RobertSwirsky/weikeypad/Weigand.3mf

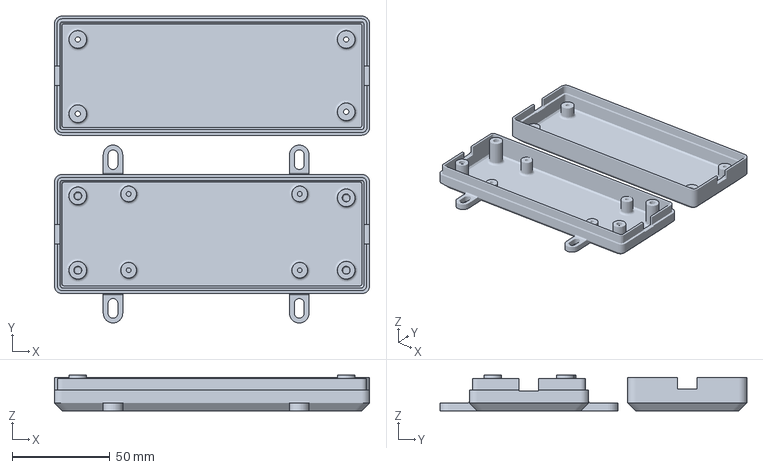
[picture p1: CAD file, 2026-02-12]
Weigand.3mf
161.2 x 157.0 x 18.2 mm
