RobertSwirsky/weikeypad/(list of files, cad)

Other CAD files:
Weigand.stl
