RobertSwirsky/weikeypad/schematic.pdf

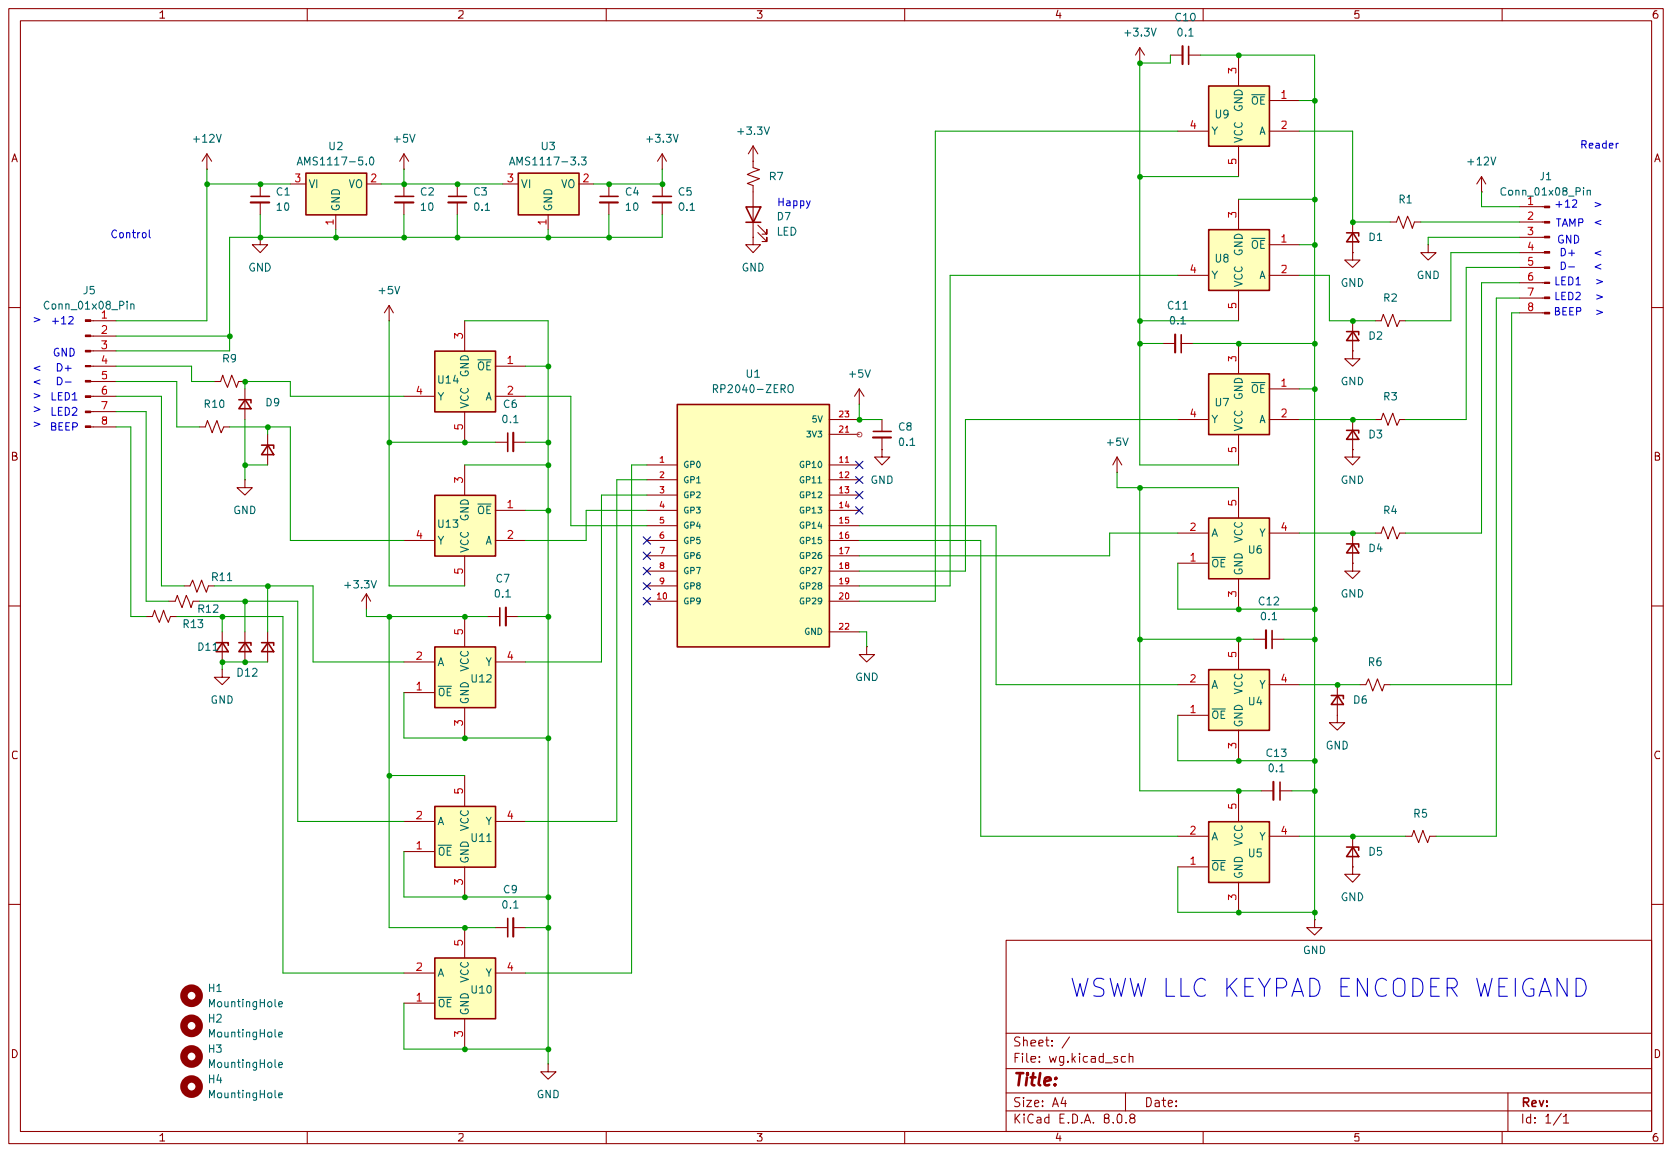
[picture p2: page 1]
