RobertSwirsky/weikeypad/KiCad/wg.kicad_pcb

## KiCad design KiCad/wg.kicad_pcb (2025-10-17)

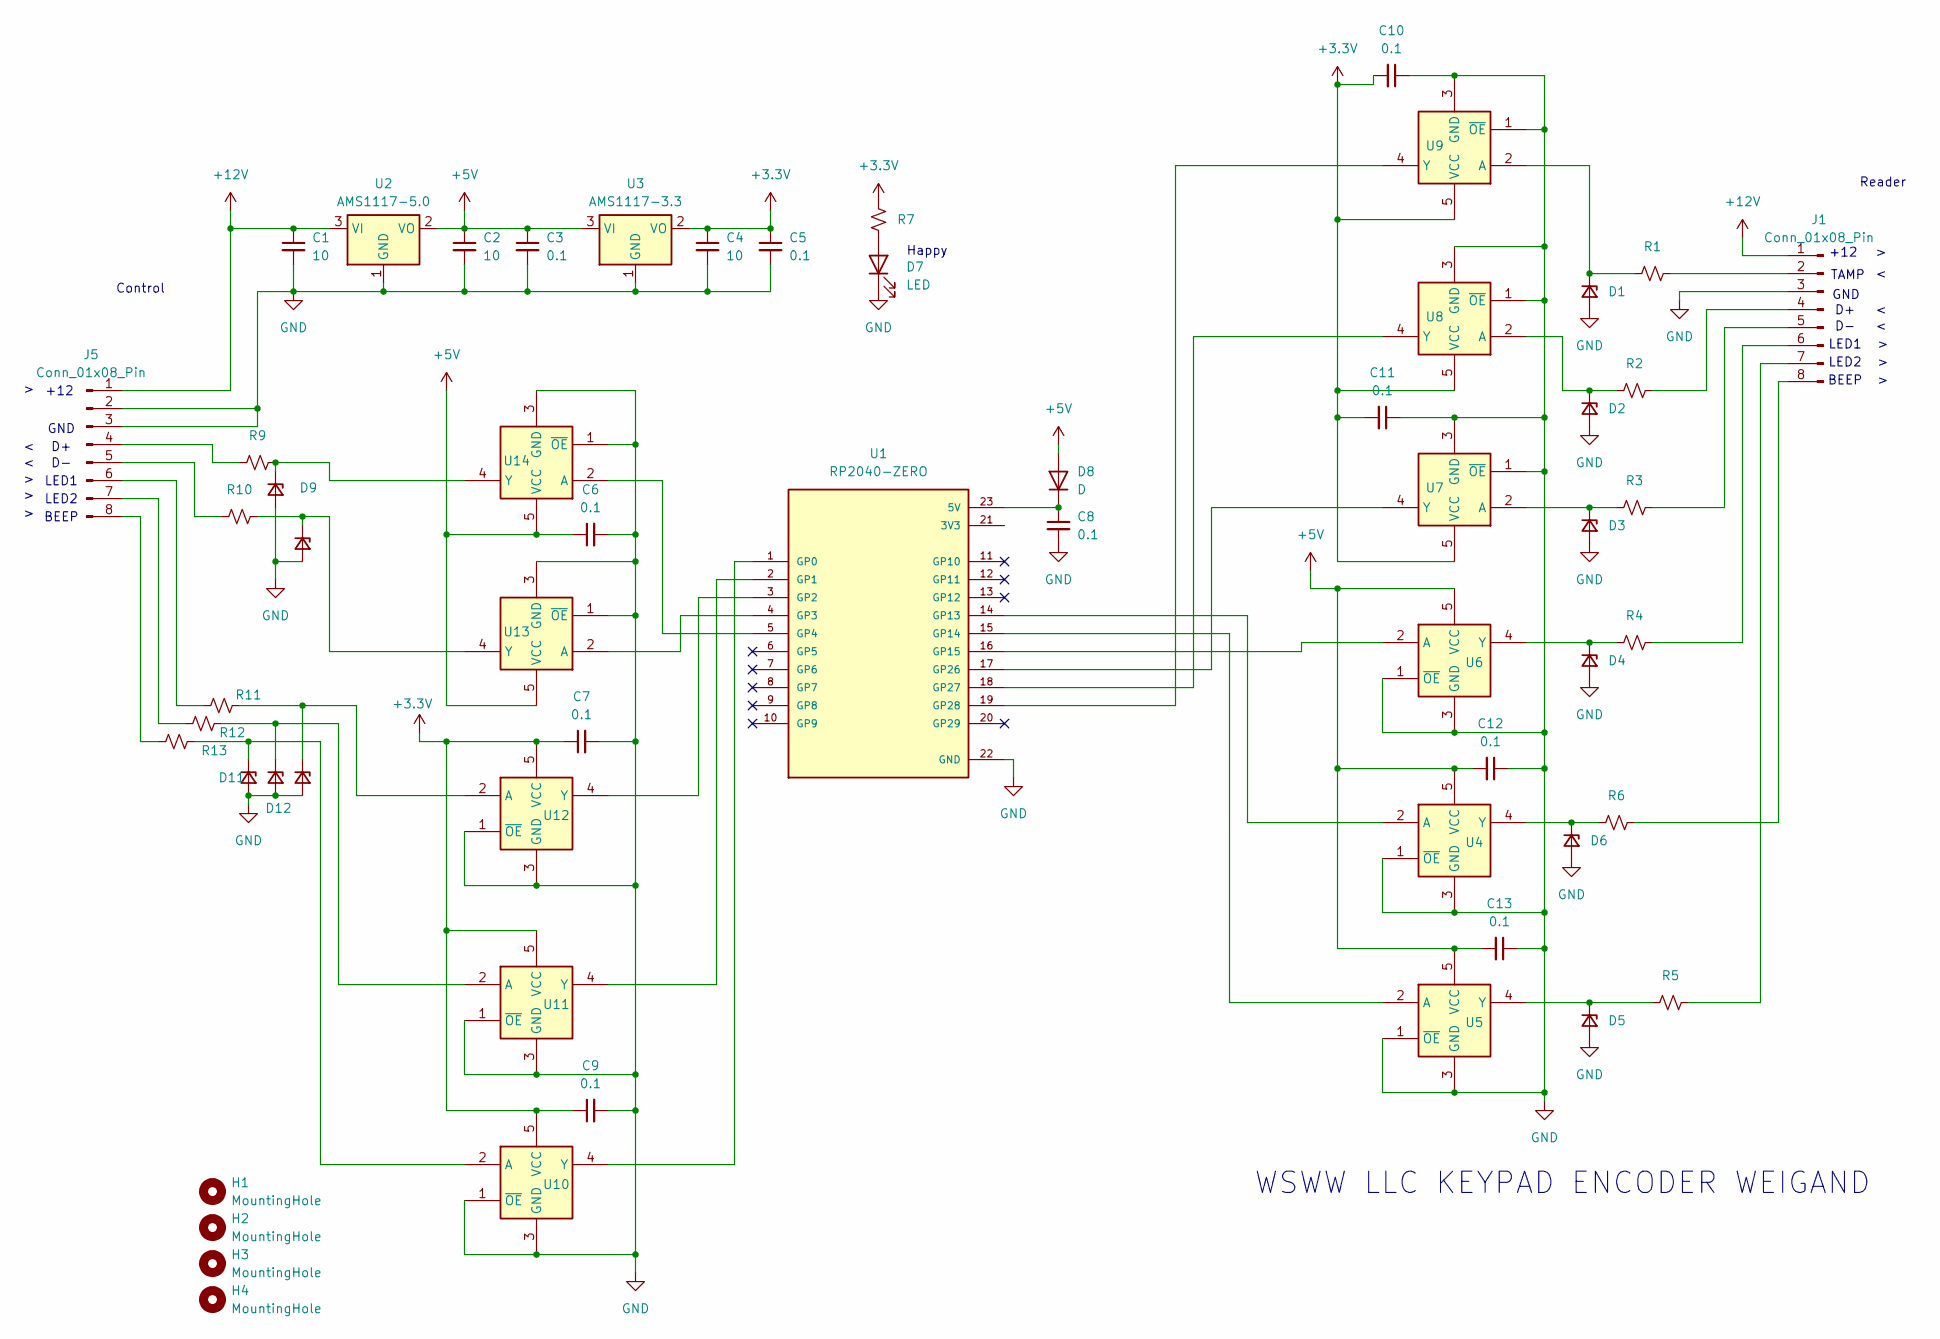
[picture p3: schematic wg.kicad_sch]

Parts:
C1, C2, C4: 10; CP_Radial_D4.0mm_P2.00mm
C3, C5, C6, C7, C8, C9, C10, C11, C12, C13: 0.1; C_Disc_D3.0mm_W1.6mm_P2.50mm
D1, D2, D3, D4, D5, D6, D9, D10, D11, D12, D13: D_Zener_Small; D_SOD-323_HandSoldering
D7: LED; R_1206_3216Metric_Pad1.30x1.75mm_HandSolder
D8: D
H1, H2, H3, H4: MountingHole; MountingHole_3mm
J1, J5: Conn_01x08_Pin; PhoenixContact_MC_1,5_8-G-3.5_1x08_P3.50mm_Horizontal
R1, R2, R3, R4, R5, R6, R7, R9, R10, R11, R12, R13: R_Small_US; R_1206_3216Metric_Pad1.30x1.75mm_HandSolder
U1: RP2040-ZERO; MODULE_RP2040-ZERO; PARTREV NA
U2: AMS1117-5.0; SOT-223-3_TabPin2
U3: AMS1117-3.3; SOT-223-3_TabPin2
U4, U5, U6, U7, U8, U9, U10, U11, U12, U13, U14: NC7SZ125M5X; SOT-23-5

Connections:
+3.3V: C4.1, C5.1, C7.1, C9.1, C10.2, C11.2, R7.2, U3.2 (VO), U7.5 (VCC), U8.5 (VCC), U9.5 (VCC), U10.5 (VCC), U11.5 (VCC), U12.5 (VCC)
+12V: C1.1, J1.1, J5.1, U2.3 (VI)
GND: C1.2, C2.2, C3.2, C4.2, C5.2, C6.2, C7.2, C8.2, C9.2, C10.1, C11.1, C12.1, C13.1, D1.2 (A), D2.2 (A), D3.2 (A), D4.2 (A), D5.2 (A), D6.2 (A), D7.1 (K), D9.2 (A), D10.2 (A), D11.2 (A), D12.2 (A), D13.2 (A), J1.3, J5.2, J5.3, U1.22 (GND), U2.1 (GND), U3.1 (GND), U4.1 (~OE), U4.3 (GND), U5.1 (~OE), U5.3 (GND), U6.1 (~OE), U6.3 (GND), U7.1 (~OE), U7.3 (GND), U8.1 (~OE), U8.3 (GND), U9.1 (~OE), U9.3 (GND), U10.1 (~OE), U10.3 (GND), U11.1 (~OE), U11.3 (GND), U12.1 (~OE), U12.3 (GND), U13.1 (~OE), U13.3 (GND), U14.1 (~OE), U14.3 (GND)
unnamed: D1.1 (K), R1.1, U9.2 (A)
unnamed: D2.1 (K), R2.1, U8.2 (A)
unnamed: D3.1 (K), R3.1, U7.2 (A)
unnamed: D4.1 (K), R4.1, U6.4 (Y)
unnamed: D5.1 (K), R5.1, U5.4 (Y)
unnamed: D6.1 (K), R6.1, U4.4 (Y)
unnamed: D7.2 (A), R7.1
unnamed: D9.1 (K), R9.2, U14.4 (Y)
unnamed: D10.1 (K), R10.2, U13.4 (Y)
unnamed: D11.1 (K), R13.2, U10.2 (A)
unnamed: D12.1 (K), R12.2, U11.2 (A)
unnamed: D13.1 (K), R11.2, U12.2 (A)
unnamed: J1.2, R1.2
unnamed: J1.4, R2.2
unnamed: J1.5, R3.2
unnamed: J1.6, R4.2
unnamed: J1.7, R5.2
unnamed: J1.8, R6.2
unnamed: J5.4, R9.1
unnamed: J5.5, R10.1
unnamed: J5.6, R11.1
unnamed: J5.7, R12.1
unnamed: J5.8, R13.1
unnamed: U1.1 (GP0), U10.4 (Y)
unnamed: U1.2 (GP1), U11.4 (Y)
unnamed: U1.3 (GP2), U12.4 (Y)
unnamed: U1.4 (GP3), U13.2 (A)
unnamed: U1.5 (GP4), U14.2 (A)
unnamed: U1.14 (GP13), U4.2 (A)
unnamed: U1.15 (GP14), U5.2 (A)
unnamed: U1.16 (GP15), U6.2 (A)
unnamed: U1.17 (GP26), U7.4 (Y)
unnamed: U1.18 (GP27), U8.4 (Y)
unnamed: U1.19 (GP28), U9.4 (Y)

Notes on the sheet:
LED2
LED1
+12
Reader
TAMP
Happy
GND
BEEP
Control
WSWW LLC KEYPAD ENCODER WEIGAND

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
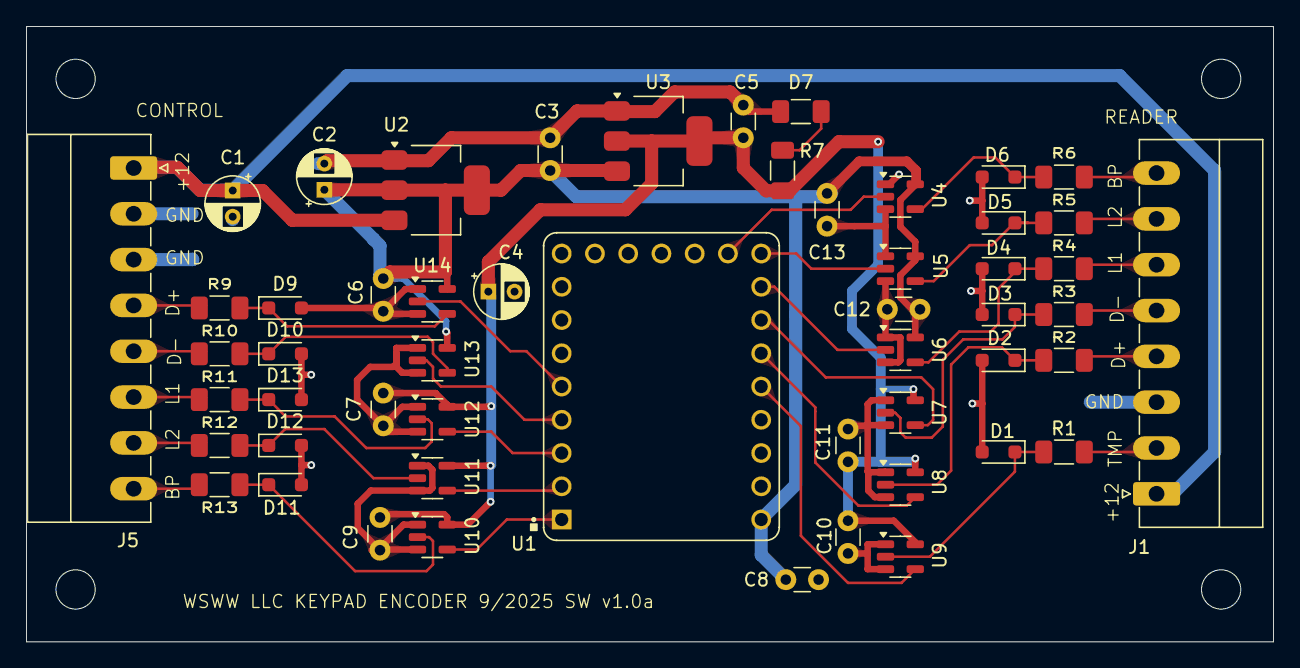
[picture p4: board wg.kicad_pcb from above]

Board: 2 copper layers, 95.2 x 47.0 mm, 57 parts (0 on the bottom side), 38 nets.
