RobertSwirsky/weikeypad/(commit log)

2025-02-07 Initial bugfixes for Micropython syntax
    [weikeypad.py]
2025-02-07 Removed debug prints
2025-02-07 Set pull-up/down values correctly. Clear ISR if no bits
    [weikeypad.py]
2025-02-08 Trying different pullup/down options Switched to pin 16/17
2025-02-27 Fix transmit code -- active high
    [weikeypad.py]
2025-04-02 Test of Micropython timers
2025-09-05 Added schematic
2025-09-10 Moved I/O pins to match latest schematic
2025-10-16 Changed I/O to match latest schematic
2025-10-16 Fixed pin assignments
2025-10-17 Fixed typo in weikepad
    [weikeypad.py]
2025-10-17 Added in KiCad project
    [wg.kicad_pcb, wg.kicad_sch]
2025-10-22 Added test code for LED, BEEP
2025-10-22 LED Control
2025-11-13 Sync the LED and BEEP lines from the controller with the keypad
2025-12-18 Design for 3D printable case
    [Weigand.3mf, Weigand.scad, Weigand.stl]
2026-01-13 Updated design for 3D printable case for the openings for the wires
    [Weigand.3mf, Weigand.scad, Weigand.stl]
2026-01-16 Tamper interrupt code -- three possible scenarios
2026-01-17 Remove pull-up from tamper pin
2026-01-18 Fixed box to put screwholes on top
    [Weigand.scad]
2026-01-19 put the screwholes in the top
    [Weigand.scad]
2026-01-19 Update for holes on top, high quality print mode, 30% infil
    [Weigand.3mf, Weigand.stl]
2026-01-20 Made the fill denser
    [Weigand.3mf]
2026-02-12 Send a different code F000911 or F000912 depending on whether tamper is set or cleared
    [Weigand.3mf, Weigand.scad]
